Hsury/Simple-Calculator/README.md

# Simple-Calculator
Please visit https://kagamiz.com/simple-calculator/ for details.
