Hsury/Simple-Calculator/Simple-Calculator.ino

/*
 * 项目名称：简易计算器
 * 版本：2016/10/23
 */
#include <EEPROM.h> //导入EEPROM操作库
#include <Keypad.h> //导入扫描键盘库
#include <U8glib.h> //导入OLED驱动库
U8GLIB_SSD1306_128X64 u8g(U8G_I2C_OPT_NONE); //采用SSD1306芯片方案并以I2C方式与OLED进行沟通
const byte ROWS = 4; //设置矩阵键盘行数为4
const byte COLS = 4; //设置矩阵键盘列数为4
char str[9] = ""; //以字符串形式存储输入的数字内容
int x = 0; //动画坐标
int symbol = 0; //运算符号位
double a = 0; //方程参数a
double b = 0; //方程参数b
double result = 0; //基本运算结果
short arrow = 0; //字符串指针
short buzzer = 0; //声音
short deltime = 0; //删除键按下时长
short digits = 0; //精度
short light = 0; //LED强度
short maxlength = 0; //允许输入的最大长度
short menu = 0; //附加功能状态
short numtosave = 0; //预存数字
short savednum = 0; //已存数字
short stat = 0; //状态指示
char keys[ROWS][COLS] = { //开数组以映射按键
  {'7', '8', '9', '+'},
  {'4', '5', '6', '-'},
  {'1', '2', '3', '*'},
  {'0', '.', '=', '/'}
};
byte rowPins[ROWS] = {5, 6, 13, 12}; //设置矩阵键盘行引脚
byte colPins[COLS] = {3, 4, 7, 8}; //设置矩阵键盘列引脚

static unsigned char u8g_welcome[] U8G_PROGMEM = //欢迎
{
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
      u8g.drawHLine( 128 - 2 * x, 63, 128);
      u8g.drawVLine(0, 0, x);
      u8g.drawVLine(127, 64 - x, 64);
    } while (u8g.nextPage());
  } while (x < 64);
  if (buzzer == 1) digitalWrite(11, HIGH); //开启蜂鸣器
  delay(50);
  digitalWrite(11, LOW); //关闭蜂鸣器
  analogWrite(10, 10);
  light = 0;
}

void loop() {
  char key = keypad.getKey(); //取得矩阵键盘按键情况
  if (digitalRead(9) == LOW) { //判断退格键是否按下
    deltime++;
    if (deltime <= 3) key = 'B'; //一级删除
    if (deltime == 6) { //二级删除
      key = 'B';
      arrow = 0; //指针复位
      memset(str, 0, sizeof(str)); //清空输入字符串
      symbol = 0; //清空运算符
    }
    screencontroller();
  }
  if (digitalRead(9) == HIGH) deltime = 0; //复位时长
  if (digitalRead(2) == LOW) { //判断高级运算键是否按下
    key = 'A';
    if (menu == 0) menu = 9;
  }
  if (key) {
    if (strchr(str, '.') == 0) maxlength = 6;
    else maxlength = 7;
    switch (key) //对返回的按键进行讨论
    {
      case 'A': //按下高级运算键
        break;

      case 'B': //按下退格键
        if (arrow != 0) arrow--; //前移指针时防止下标越界
        str[arrow] = '\0'; //通过在指针位置标记结束位来缩短字符串长度
        if (menu == 2) {
          numtosave = atoi(str);
          EEPROM.write(0, numtosave / 100); //将位1写入EEPROM
          EEPROM.write(1, (numtosave / 10) % 10); //将位2写入EEPROM
          EEPROM.write(2, numtosave % 10); //将位3写入EEPROM
        }
        break;

      case '+': //按下加号
        if (menu == 0) {
          process();
          symbol = 1; //保存加号到符号位
        }
        break;

      case '-': //按下减号
        if (menu == 0) {
          process();
          symbol = 2; //保存减号到符号位
        }
        break;

      case '*': //按下乘号
        if (menu == 0) {
          process();
          symbol = 3; //保存乘号到符号位
        }
        break;

      case '/': //按下除号
        if (menu == 0) {
          process();
          symbol = 4; //保存除号到符号位
        } else if (menu == 1 || menu == 9) { //判断除号此时是否用于返回
          menu = 0;
        } else if (menu > 1 && menu != 9) menushow();
        break;

      case '.':
        if (menu != 1 && menu != 2 && menu != 6 && strchr(str, '.') == 0 && arrow <= maxlength) str[arrow++] = key; //限制输入小数点为一位且控制字符串长度以防止下标越界
        break;

      case '=':
        if (menu == 0) {
          stat = 1; //记录等号按下状态
          process();
          symbol = 0; //将符号位恢复为初始状态
        } else if (menu == 3) {
          a = atof(str); //输入参数a
          menu = 4;
          arrow = 0; //指针复位
          memset(str, 0, sizeof(str)); //清空输入字符串
        } else if (menu == 4) {
          b = atof(str); //输入参数b
          menu = 5;
        }
        break;

      default:
        switch (menu) {
          case 0: //四则运算状态
            if (str[0] == '0' && arrow == 1) arrow = 0; //不允许输入的数以一个或更多的0开头
            if (arrow <= maxlength) str[arrow++] = key; //控制字符串长度以防止下标越界
            break;

          case 1: //已进入菜单状态
            switch (key) {
              case '0':
                menu = 10; //进入按键说明
                break;

              case '1':
                menu = 2; //进入功能1并改变附加功能状态
                savednum = EEPROM.read(0) * 100 + EEPROM.read(1) * 10 + EEPROM.read(2); //将EEPROM中3个地址位的值进行合并
                break;

              case '2':
                menu = 3;//进入功能2并改变附加功能状态
                break;

              case '3':
                menu = 6; //进入功能3并改变附加功能状态
                digits = EEPROM.read(3);
                break;

              case '4':
                menu = 7; //进入功能4并改变附加功能状态
                buzzer = EEPROM.read(4);
                break;

              case '5':
                menu = 8; //进入功能5并改变附加功能状态
                break;
            }
            break;

          case 2: //数值保存状态
            if (str[0] == '0' && arrow == 1) arrow = 0; //不允许输入的数以一个或更多的0开头
            if (arrow <= 2) str[arrow++] = key; //控制字符串长度以防止下标越界
            numtosave = atoi(str);
            EEPROM.write(0, numtosave / 100); //将位1写入EEPROM
            EEPROM.write(1, (numtosave / 10) % 10); //将位2写入EEPROM
            EEPROM.write(2, numtosave % 10); //将位3写入EEPROM
            break;

          case 3:
            if (str[0] == '0' && arrow == 1) arrow = 0; //不允许输入的数以一个或更多的0开头
            if (arrow <= maxlength) str[arrow++] = key; //控制字符串长度以防止下标越界
            break;

          case 4:
            if (str[0] == '0' && arrow == 1) arrow = 0; //不允许输入的数以一个或更多的0开头
            if (arrow <= maxlength) str[arrow++] = key; //控制字符串长度以防止下标越界
            break;

          case 6:
            if (key - '0' <= 6) digits = key - '0';
            EEPROM.write(3, digits); //保存精度设置到EEPROM
            break;

          case 7:
            if (key - '0' <= 1) buzzer = key - '0';
            EEPROM.write(4, buzzer); //保存声音设置到EEPROM
            break;

          case 9:
            if (arrow != 0) result = atof(str); //判断对哪一次输入进行运算
            switch (key) {
              case '1': //-x
                result = -result;
                break;

              case '2': //|x|
                result = abs(result);
                break;

              case '3': //x^2
                result =  result * result;
                break;

              case '4': //x^3
                result =  result * result * result;
                break;

              case '5': //x^(1/2)
                result =  sqrt(result);
                break;

              case '6': //x^(1/3)
                result =  pow(result, 1.0 / 3);
                break;

              case '7': //exp(x)
                result = exp(result);
                break;

              case '8': //ln(x)
                result = log(result);
                break;
            }
            menu = 0; //退回基本运算界面
            arrow = 0; //指针复位
            memset(str, 0, sizeof(str)); //清空输入字符串
            stat = 1; //将状态改为运算完毕
            symbol = 0; //复位符号
            break;

          case 10: //已进入操作指南
            switch (key) {
              case '1':
                menu = 2; //进入功能1并改变附加功能状态
                savednum = EEPROM.read(0) * 100 + EEPROM.read(1) * 10 + EEPROM.read(2); //将EEPROM中3个地址位的值进行合并
                break;

              case '2':
                menu = 3;//进入功能2并改变附加功能状态
                break;

              case '3':
                menu = 6; //进入功能3并改变附加功能状态
                digits = EEPROM.read(3);
                break;

              case '4':
                menu = 7; //进入功能4并改变附加功能状态
                buzzer = EEPROM.read(4);
                break;

              case '5':
                menu = 8; //进入功能5并改变附加功能状态
                break;
            }
            break;
        }
        break;
    }
    analogWrite(10, 80);
    if (buzzer == 1) {
      digitalWrite(11, HIGH); //开启蜂鸣器
      delay(10);
      digitalWrite(11, LOW); //关闭蜂鸣器
    }
    screencontroller();
    analogWrite(10, 10);
  }
}

void process() {
  str[arrow] = '\0'; //对指针位置标记字符串结束
  if (arrow != 0) { //判断键入是否为空
    switch (symbol) //对上一次的符号位进行讨论
    {
      case 0: //不存在上一次的符号
        result = atof(str);
        break;

      case 1: //上一次的符号为加号
        result = result + atof(str); //执行加法运算
        break;

      case 2: //上一次的符号为减号
        result = result - atof(str); //执行减法运算
        break;

      case 3: //上一次的符号为乘号
        result = result * atof(str); //执行乘法运算
        break;

      case 4: //上一次的符号为除号
        if (atof(str) != 0) result = result / atof(str); //在除数不为0的情况下执行除法运算
        else stat = 2; //若除数为0则标记状态异常
        break;
    }
    arrow = 0; //指针复位
    memset(str, 0, sizeof(str)); //清空输入字符串
  }
}

void screencontroller() {
  switch (menu) {
    case 0: //未进入菜单的画面绘制
      switch (stat) {
        case 0: //四则运算的画面绘制
          if (symbol == 0) { //无符号输入界面
            u8g.firstPage();
            do {
              u8g.drawXBMP( 0, 0, 128, 32, u8g_uestc);
              u8g.setPrintPos(0, 46);
              u8g.print(str);
            } while (u8g.nextPage());
          } else { //带符号输入界面
            u8g.firstPage();
            do {
              u8g.drawXBMP( 0, 0, 128, 32, u8g_uestc);
              u8g.setPrintPos(0, 46);
              u8g.print(result, digits);
              u8g.setPrintPos(0, 63);
              u8g.print(str);
              u8g.setPrintPos(127 - 11, 63);
              switch (symbol) {
                case 1:
                  u8g.print('+');
                  break;

                case 2:
                  u8g.print('-');
                  break;

                case 3:
                  u8g.print('*');
                  break;

                case 4:
                  u8g.print('/');
                  break;
              }
            } while (u8g.nextPage());
          }
          break;

        case 1: //运算结果的画面绘制
          u8g.firstPage();
          do {
            u8g.drawXBMP( 0, 0, 128, 32, u8g_uestc);
            u8g.setPrintPos(0, 46);
            u8g.print(result, digits);
            u8g.setPrintPos(127 - 11, 63);
            u8g.print('=');
          } while (u8g.nextPage());
          stat = 0;
          break;

        case 2: //出错的画面绘制
          x = 1;
          do { //除数为0的弹错动画
            light = light + 10;
            analogWrite(10, light);
            u8g.firstPage();
            do {
              u8g.drawXBMP( 0, 0, 128, 32, u8g_error);
              u8g.setPrintPos(x, 46);
              u8g.print("Error!");
              u8g.setPrintPos(61 - x, 63);
              u8g.print("Orz...");
            } while (u8g.nextPage());
            x = x + 10;
          } while (x < 61);
          delay (500);
          menushow();
          if (buzzer == 1) digitalWrite(11, HIGH); //开启蜂鸣器
          delay(50);
          digitalWrite(11, LOW); //关闭蜂鸣器
          analogWrite(10, 10);
          light = 0;
          break;
      }
      break;

    case 2: //断电存储的画面绘制
      u8g.firstPage();
      do {
        u8g.drawXBMP( 0, 0, 128, 32, u8g_eeprom);
        u8g.setPrintPos(0, 46);
        u8g.print("EEPROM:");
        u8g.setPrintPos(77, 46);
        u8g.print(savednum);
        u8g.setPrintPos(0, 63);
        u8g.print("Rewrite:");
        u8g.drawStr(127 - u8g.getStrWidth(str), 63, str);
      } while (u8g.nextPage());
      break;

    case 3: //解方程一级画面绘制
      u8g.firstPage();
      do {
        u8g.drawXBMP( 0, 0, 128, 32, u8g_fx);
        u8g.setPrintPos(0, 46);
        u8g.print("STEP 1");
        u8g.setPrintPos(0, 63);
        u8g.print("a=");
        u8g.drawStr(127 - u8g.getStrWidth(str), 63, str);
      } while (u8g.nextPage());
      break;

    case 4: //解方程二级画面绘制
      u8g.firstPage();
      do {
        u8g.drawXBMP( 0, 0, 128, 32, u8g_fx);
        u8g.setPrintPos(0, 46);
        u8g.print("STEP 2");
        u8g.setPrintPos(0, 63);
        u8g.print("b=");
        u8g.drawStr(127 - u8g.getStrWidth(str), 63, str);
      } while (u8g.nextPage());
      break;

    case 5: //解方程三级画面绘制
      u8g.firstPage();
      do {
        u8g.drawXBMP( 0, 0, 128, 32, u8g_fx);
        u8g.setPrintPos(0, 46);
        u8g.print("Result:");
        u8g.setPrintPos(0, 63);
        u8g.print("x=");
        u8g.setPrintPos(22, 63);
        u8g.print(solvefx(), 5);
      } while (u8g.nextPage());
      break;

    case 6: //精度设置画面绘制
      u8g.firstPage();
      do {
        u8g.drawXBMP( 0, 0, 128, 32, u8g_setdigits);
        u8g.setPrintPos(59, 52);
        u8g.print(digits);
      } while (u8g.nextPage());
      break;

    case 7: //声音设置画面绘制
      u8g.firstPage();
      do {
        u8g.drawXBMP( 0, 0, 128, 32, u8g_setbuzzer);
        if (buzzer == 0)
        {
          u8g.setPrintPos(47, 52);
          u8g.print("OFF");
        }
        else
        {
          u8g.setPrintPos(52, 52);
          u8g.print("ON");
        }
      } while (u8g.nextPage());
      break;

    case 8: //开发者画面绘制
      u8g.firstPage();
      do {
        u8g.drawXBMP( 0, 0, 128, 64, u8g_developers);
      } while (u8g.nextPage());
      break;

    case 9: //高级运算功能
      u8g.firstPage();
      do {
        u8g.drawXBMP( 0, 0, 128, 64, u8g_exfunc);
      } while (u8g.nextPage());
      break;

    case 10: //操作指南画面绘制
      u8g.firstPage();
      do {
        u8g.drawXBMP( 0, 0, 128, 64, u8g_help);
      } while (u8g.nextPage());
      break;
  }
}

void menushow() { //主菜单界面
  menu = 1;
  stat = 0;
  arrow = 0; //指针复位
  memset(str, 0, sizeof(str)); //清空输入字符串
  result = 0;
  u8g.firstPage(); //进入菜单的动画
  do {
    u8g.drawXBMP( 0, 0, 128, 32, u8g_menu);
    u8g.setPrintPos(16, 55);
    u8g.print("-PRESS 0-");
    u8g.drawFrame(20, 39, 90, 21);
  } while (u8g.nextPage());
}

double solvefx() { //二分法求解方程函数
  double minimum = 0, maximum = 20, mid = (minimum + maximum) / 2;
  while (maximum - minimum > 1e-6)
  {
    if (fx(mid) > 0)maximum = mid;
    else if (fx(mid) < 0)minimum = mid;
    else break;
    mid = (minimum + maximum) / 2;
  }
  return mid;
}

double fx(double x) //超越方程
{
  return a * x + exp(x) - b;
}
